satellite1d/goldrop-sensor-box/README.md

# goldrop-sensor-box
Temperature and humidity sensor through wifi with 230VAC power input.

The device runs on ESP32-C3-WROOM chip utilizing the built in wifi antenna, and can be powered with usb-c or up to 230V mains.
Main purpose of the device is to collect temperature and humidity data and sending it to a server through wifi in real time.
Firmware has been vibe coded.

## Firmware
Current firmware 0.6.1 for ESP32-C3 using ESP-IDF 6.1 and PlatformIO.
more info in [`goldrop-fw/`](goldrop-fw/) 

## Schematic

Pliki schematu, PCB i bibliotek: [KiCad/](KiCad/).


## PCB design
TODO: 
  - add a picture with all components
  - varistor might not be necessary
  - maybe change the LDO to a bigger one for better longevity 


## Case design
TODO: add case photo and files
