satellite1d/goldrop-sensor-box/KiCad/goldrop.kicad_pcb

## KiCad design KiCad/goldrop.kicad_pcb (2026-11-10)

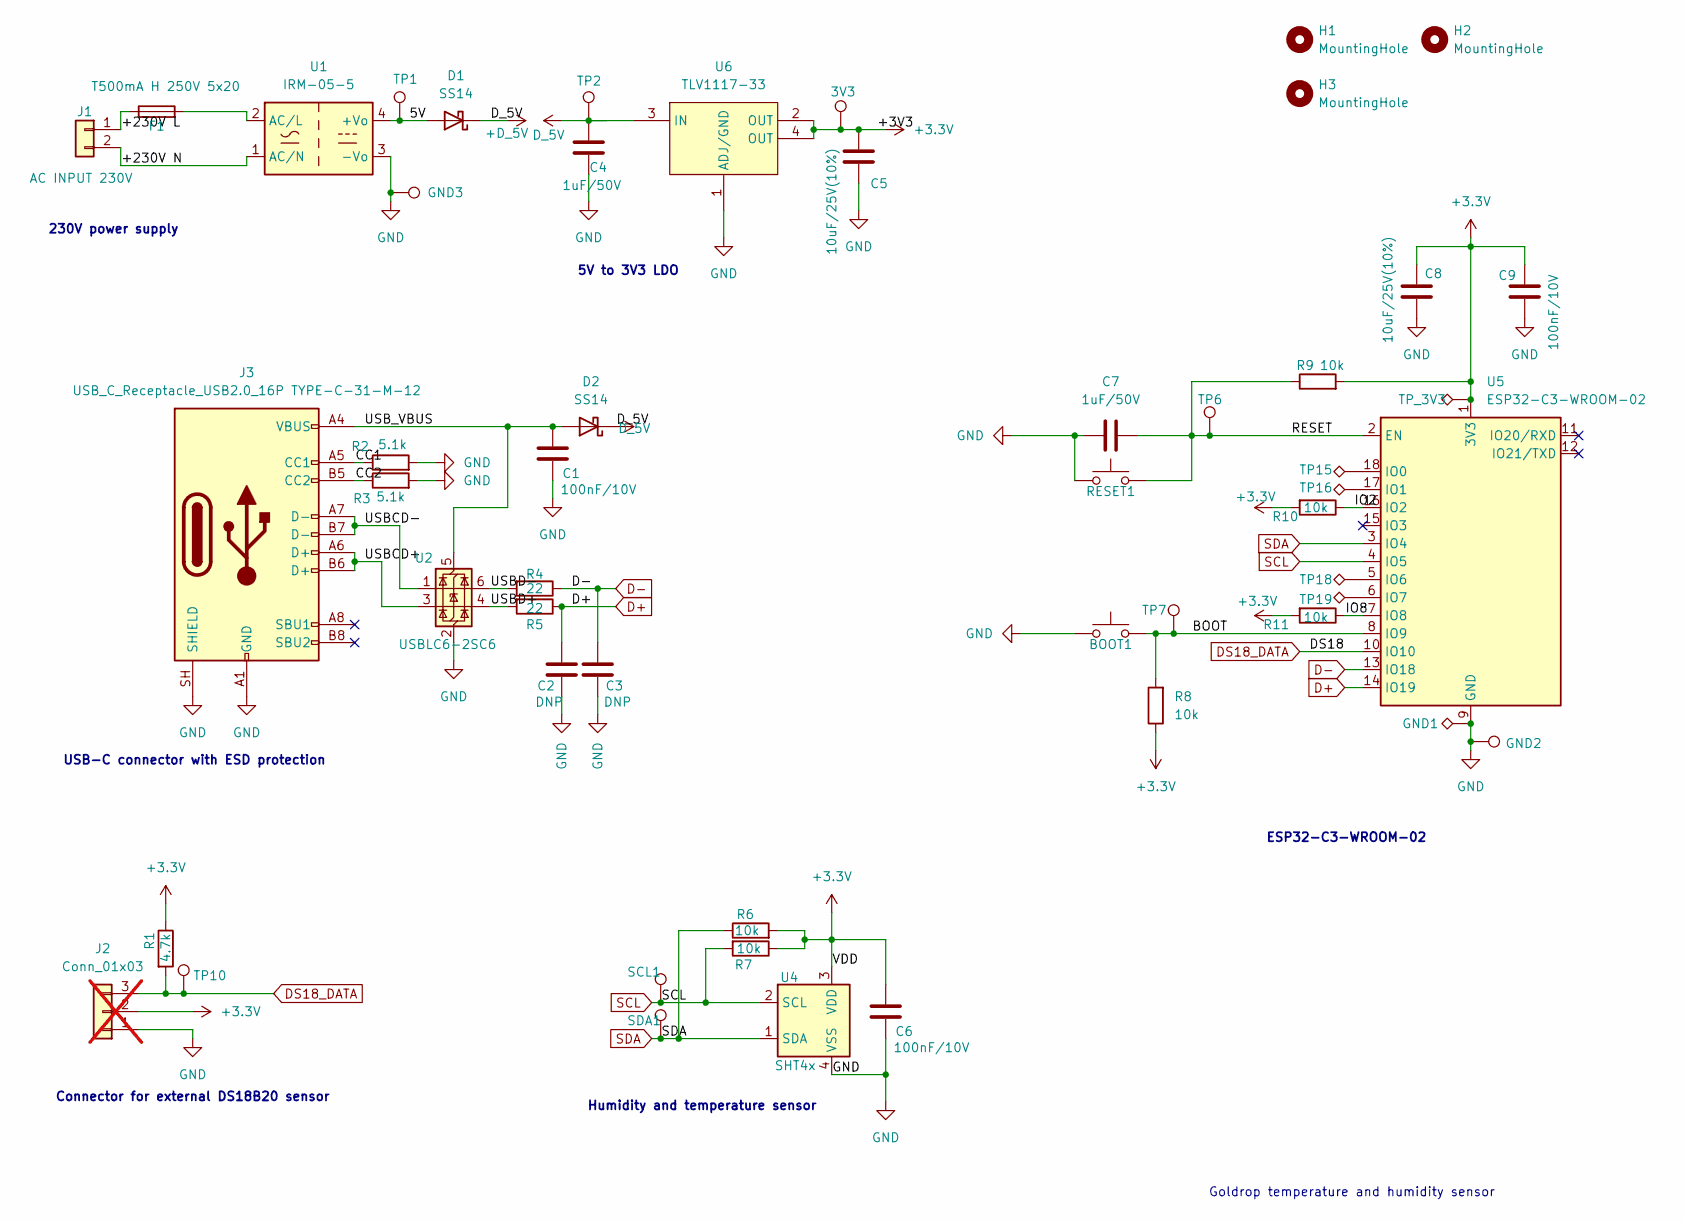
[picture p1: schematic goldrop.kicad_sch]

Parts:
3V3: TestPoint; TestPoint_Pad_D1.5mm
BOOT1: SW_Push; SW-SMD_L3.9-W3.0-P4.45; MPN TS-1088-AR02016; LCSC C720477
C1, C6, C9: 100nF/10V; C_0805_2012Metric_Pad1.18x1.45mm_HandSolder; MPN CC0805KRX7R9BB104; LCSC C49678
C2, C3: DNP; C_0805_2012Metric_Pad1.18x1.45mm_HandSolder
C4, C7: 1uF/50V; C_0805_2012Metric_Pad1.18x1.45mm_HandSolder; MPN CL21B105KBFNNNE; LCSC C28323
C5, C8: 10uF/25V(10%); C_0805_2012Metric_Pad1.18x1.45mm_HandSolder; MPN CL21A106KAYNNNE; LCSC C15850
D1, D2: SS14; D_SMA; MPN SS14; LCSC C2480
F1: T500mA H 250V 5x20; FUSE-TH_L22.6-W9.0; MPN 5x20 BLX-A XC-7; LCSC C3131
GND1: TestPoint_Alt; TestPoint_Pad_1.0x1.0mm
GND2, GND3: TestPoint; TestPoint_Pad_D1.5mm
H1, H2, H3: MountingHole; MountingHole_3.2mm_M3
J1: AC INPUT 230V; CONN-TH_2P-P7.62_DB910-7.62-2P; MPN DB910-7.62-2P-GN-S; LCSC C395876
J2: Conn_01x03; CONN-TH_3P-P5.08_KF129-5.08-3P; MPN KF129-5.08-3P; LCSC C475093; not fitted
J3: USB_C_Receptacle_USB2.0_16P TYPE-C-31-M-12; USB_C_Receptacle_HRO_TYPE-C-31-M-12; MPN TYPE-C-31-M-12; LCSC C165948
R1: 4.7k; R_0805_2012Metric_Pad1.20x1.40mm_HandSolder; MPN 0805W8F4701T5E; LCSC C17673
R2, R3: 5.1k; R_0805_2012Metric_Pad1.20x1.40mm_HandSolder; MPN 0805W8F5101T5E; LCSC C27834
R4, R5: 22; R_0805_2012Metric_Pad1.20x1.40mm_HandSolder; MPN 0805W8F220JT5E; LCSC C17561
R6, R7, R8, R9, R10, R11: 10k; R_0805_2012Metric_Pad1.20x1.40mm_HandSolder; MPN 0805W8F1002T5E; LCSC C17414
RESET1: SW_Push; SW-SMD_L3.9-W3.0-P4.45; MPN TS-1088-AR02016; LCSC C720477
SCL1: TestPoint; TestPoint_Pad_D1.5mm
SDA1: TestPoint; TestPoint_Pad_D1.5mm
TP1, TP2, TP6, TP7, TP10: TestPoint; TestPoint_Pad_D1.5mm
TP15, TP16, TP18, TP19: TestPoint_Alt; TestPoint_Pad_1.0x1.0mm
TP_3V3: TestPoint_Alt; TestPoint_Pad_1.0x1.0mm
U1: IRM-05-5; Converter_ACDC_MeanWell_IRM-05-xx_THT; MPN IRM-05-5; LCSC C48603696
U2: USBLC6-2SC6; SOT-23-6; MPN USBLC6-2SC6; LCSC C7519
U4: SHT4x; Sensirion_DFN-4_1.5x1.5mm_P0.8mm_SHT4x_NoCentralPad; MPN SHT45-AD1F-R2; LCSC C5360602
U5: ESP32-C3-WROOM-02; MPN ESP32-C3-WROOM-02-N4; LCSC C2934560
U6: TLV1117-33; SOT-223_L6.7-W3.5-P2.30-BR; MPN TLV1117LV33DCYR; LCSC C15578

Connections:
+3.3V: 3V3.1 (1_1), C5.2, C6.2, C8.2, C9.2, J2.2, R1.1, R6.2, R7.1, R8.1, R9.2, R10.2, R11.2, TP_3V3.1 (1_1), U4.3 (VDD), U5.1 (3V3), U6.2 (OUT), U6.4 (OUT)
+D_5V: C4.2, D1.1 (K), D2.1 (K), TP2.1 (1_1), U6.3 (IN)
/5V: D1.2 (A), TP1.1 (1_1), U1.4 (+Vo)
/+230V L: F1.1, J1.1
/+230V N: J1.2, U1.1 (AC/N)
/BOOT: BOOT1.2, R8.2, TP7.1 (1_1), U5.8 (IO9)
/CC1: J3.A5 (CC1), R2.1
/CC2: J3.B5 (CC2), R3.1
/IO2: R10.1, U5.16 (IO2)
/IO8: R11.1, U5.7 (IO8)
/RESET: C7.2, R9.1, RESET1.2, TP6.1 (1_1), U5.2 (EN)
/USBCD+: J3.A6 (D+), J3.B6 (D+), U2.3 (I/O2)
/USBCD-: J3.A7 (D-), J3.B7 (D-), U2.1 (I/O1)
/USBD+: R5.2, U2.4 (I/O2)
/USBD-: R4.2, U2.6 (I/O1)
/USB_VBUS: C1.2, D2.2 (A), J3.A4 (VBUS), J3.A9 (VBUS), J3.B4 (VBUS), J3.B9 (VBUS), U2.5 (VBUS)
D+: C2.2, R5.1, U5.14 (IO19)
D-: C3.2, R4.1, U5.13 (IO18)
DS18_DATA: J2.3, R1.2, TP10.1 (1_1), U5.10 (IO10)
GND: BOOT1.1, C1.1, C2.1, C3.1, C4.1, C5.1, C6.1, C7.1, C8.1, C9.1, GND1.1 (1_1), GND2.1 (1_1), GND3.1 (1_1), J2.1, J3.A1 (GND), J3.A12 (GND), J3.B1 (GND), J3.B12 (GND), J3.SH (SHIELD), R2.2, R3.2, RESET1.1, U1.3 (-Vo), U2.2 (GND), U4.4 (VSS), U5.9 (GND), U5.19 (GND), U6.1 (ADJ/GND)
unnamed: F1.2, U1.2 (AC/L)
unnamed: TP15.1 (1_1), U5.18 (IO0)
unnamed: TP16.1 (1_1), U5.17 (IO1)
unnamed: TP18.1 (1_1), U5.5 (IO6)
unnamed: TP19.1 (1_1), U5.6 (IO7)
SCL: R7.2, SCL1.1 (1_1), U4.2 (SCL), U5.4 (IO5)
SDA: R6.1, SDA1.1 (1_1), U4.1 (SDA), U5.3 (IO4)

Notes on the sheet:
Connector for external DS18B20 sensor
Humidity and temperature sensor
USB-C connector with ESD protection
230V power supply
Goldrop temperature and humidity sensor
ESP32-C3-WROOM-02
5V to 3V3 LDO

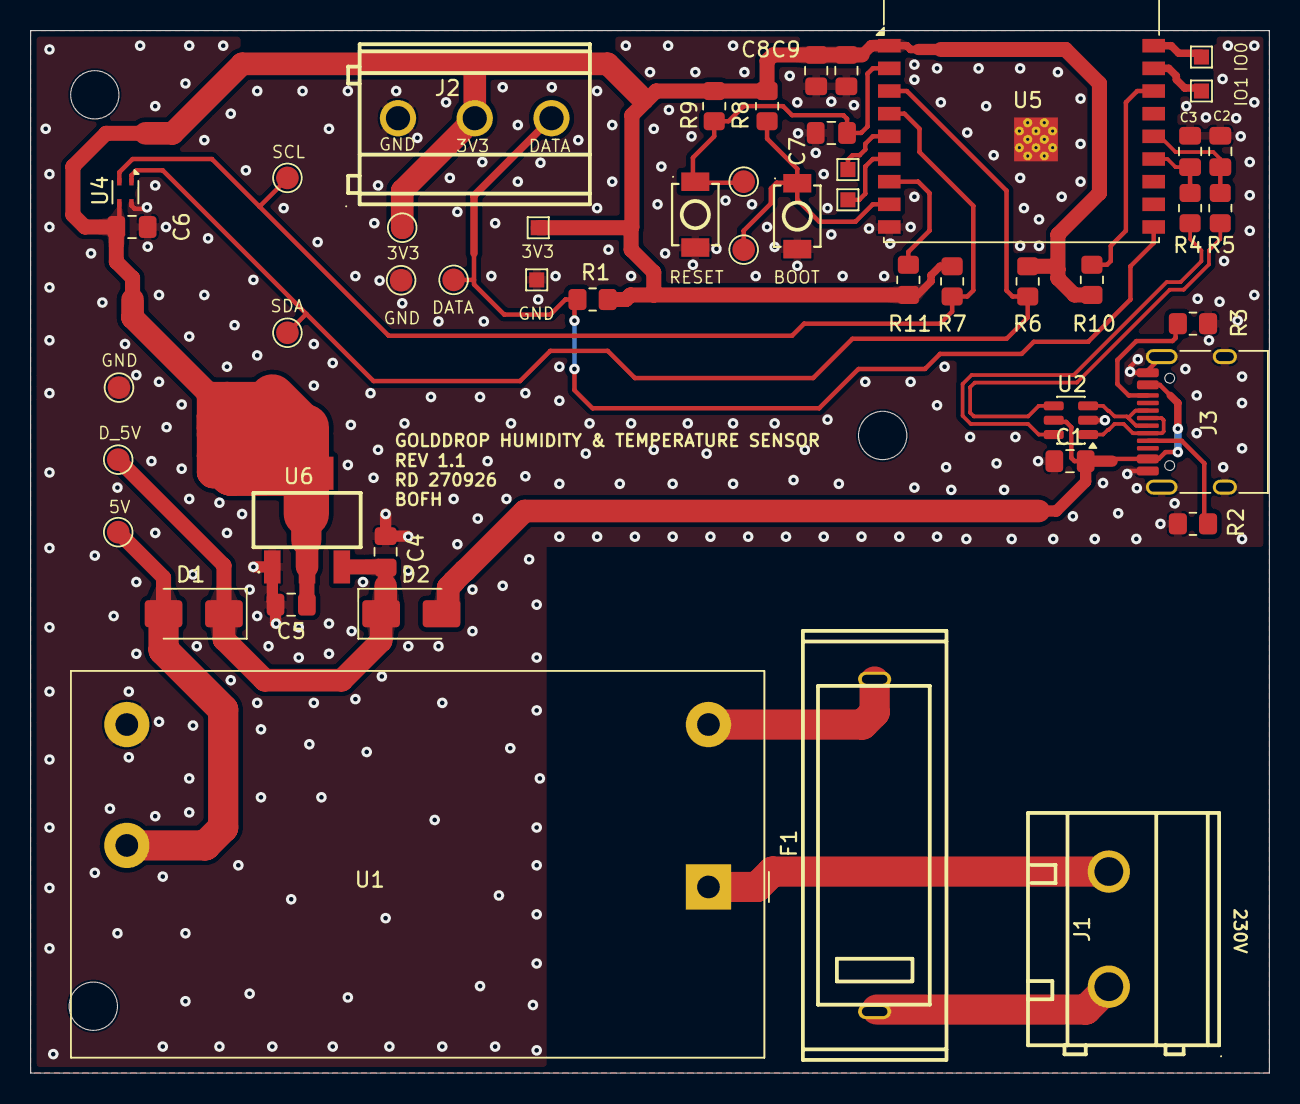
[picture p2: board goldrop.kicad_pcb from above]

Board: 2 copper layers, 82.0 x 69.0 mm, 52 parts (0 on the bottom side), 27 nets.
