satellite1d/goldrop-sensor-box/(commit log)

2026-10-04 first commit - pcb files with simulation setup test
    [bom.csv, designators.csv, goldrop.kicad_pcb, goldrop.kicad_sch, positions.csv]
2026-11-03 Add Goldrop firmware 0.6.1 and management dashboard
    Add ESP-IDF firmware, persistent telemetry, signed OTA, remote configuration,
    Python measurement and management services, and automated tests.
    Keep working documentation, credentials, databases and generated artifacts
    out of version control; update project entry points and include current
    hardware and board-test source changes.
    [partitions.csv]
2026-11-10 Add environment launchers and organize KiCad project
    Add idempotent server and SSH tunnel controls with process ownership, port
    and API checks. Include launchers in the server package and cover startup,
    shutdown, conflicts and partial failure with integration tests.
    Publish the current hardware project under KiCad, including updated models,
    and remove obsolete production exports. Keep the local parts worksheet
    ignored at any directory depth.
    Validation: all 14 CTest suites pass; staged Gitleaks scan has no findings.
    [bom.csv, designators.csv, goldrop.kicad_pcb, goldrop.kicad_sch, positions.csv]
2026-11-10 Update current PCB routing and schematic
    [goldrop.kicad_pcb, goldrop.kicad_sch]
2026-11-10 added J2 connector to DNP to save costs
    [goldrop.kicad_pcb, goldrop.kicad_sch]
